openoct/OCT-Spectrometer-800nm/Mechanics/readme.md

# Open OCT Spectrometer Mechanical Design

This directory contains the CAD files, assembly instructions, and parts buy sheet for the mechanical design of the OCT Spectrometer. CAD files are designed in Autodesk Inventor 2025 and converted to .stp format.

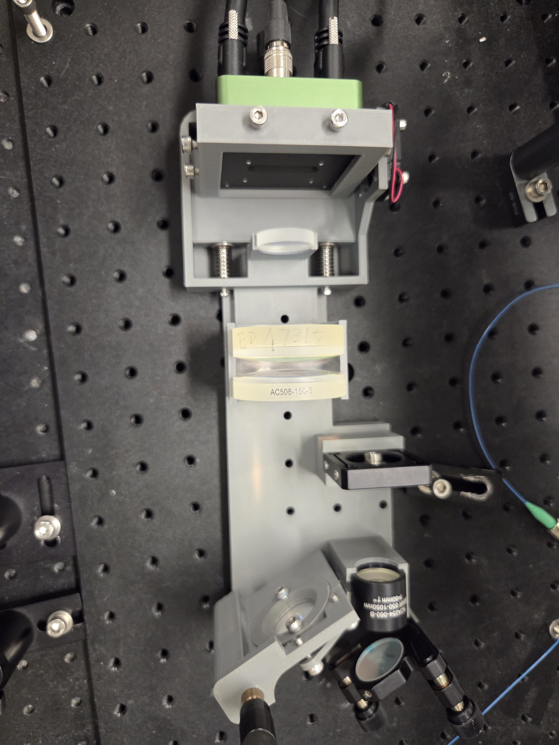
[picture p1: Mechanics/OCT_Spectrometer_v1/OCT Spectrometer Design Photo.jpg]
Photo of the fully assembled spectrometer design.


# Parts Buy List

The [Parts buy list](<OCT_Spectrometer_v1/OCT Spectrometer Parts List - V1.xlsx>) provides all of the components including the optical components listed in the optics repository, along with item count, pricing, and links for purchase.

| Part | Count |
| :--- | :--- |
| ACA254-060-B Thorlabs Lens | 1 |
| AC508-150-B Thorlabs Lens | 1 |
| E-47-318 Fosco Lens | 1 |
| LC1582Thorlabs Lens | 1 |
| 1200 l/mm @ 840 nm CWL Wasatch Photonics Grating | 1 |
| CP08 SM1-Threaded 30 mm Cage Plate Thorlabs | 1 |
| KM100 Mirror Mount Thorlabs | 1 |
| BB1-E03 Mirror Thorlabs | 1 |
| SM1FCA2 Fiber Adapter Plate Thorlabs | 1 |
| ER3 Cage assembly rod Thorlabs | 2 |
| 1/4" - 80 Bronze threaded bushing Thorlabs 0.57" | 2 |
| 1/4" - 80 Fine adjustment screw and knob Thorlabs 1.50" | 2 |
| 7119N117 Ultra-Low-Friction Oil-Embedded Sleeve Bearing McMasterCarr | 4 |
| 28.5 mm x 7mm x 1mm Compression Spring McMasterCarr | 3 |
| EV71YO1 Octoplus CCD Camera (Green) | 1 |
| 5V - 0.17A Fan, CanaKit | 1 |
| M3 - 10mm screw | 4 |
| M4 - 12mm screw | 5 |
| M4 - 25mm screw  | 1 |
| 4-40 - 3/8" screw | 4 |
| M4 - 16mm screw | 1 |
| M4 - Nut | 1 |
| 3D printed components | Full Set |

# Printed Components

This spectrometer contains 3D printed components made of PLA using a Bambu P1S 3D printer. Further printing specification are included in the assembly instructions. The printer contains three 3D components. They have been converted to .stp CAD files for inter-program usage:

The [Grating Casing 1.](<OCT_Spectrometer_v1/Grating Casing 1.stp>)

The [Grating Casing 2.](<OCT_Spectrometer_v1/Grating Casing 2.stp>)

The [Grating Clamp.](<OCT_Spectrometer_v1/Grating Clamp.stp>)

There is also an [Assembly File](<OCT_Spectrometer_v1/OCT Spectrometer Assembly.stp>) for better visualization of the proper CAD arrangement.

# Assembly Instructions

A PDF of [Assembly Instructions](<OCT_Spectrometer_v1/OCT Spectrometer Assembly Instructions.pdf>) is provided to demonstrate the assembly process using the parts listed in the parts buy list.
