openoct/OCT-Spectrometer-800nm/Optics/Zemax_Prescription_Data.md

# Zemax Prescription Data

> Reformatted from the Zemax `System/Prescription Data` text export for easier reading. All numerical values and prescription entries are retained from the source.

## General Lens Data

| Parameter | Value | Note |
| :--- | :--- | :--- |
| Surfaces | 21 |  |
| Stop | 6 |  |
| System Aperture | Object Space NA = 0.13 |  |
| Fast Semi-Diameters | On |  |
| Field Unpolarized | On |  |
| Convert thin film phase to ray equivalent | On |  |
| J/E Conversion Method | X Axis Reference |  |
| Glass Catalogs | SCHOTT CORNING INFRARED MISC |  |
| Ray Aiming | Off |  |
| Apodization | Gaussian, factor = 1.00000E+00 |  |
| Reference OPD | Exit Pupil |  |
| Paraxial Rays Setting | Ignore Coordinate Breaks |  |
| Method to Compute F/# | Tracing Rays |  |
| Method to Compute Huygens Integral | Auto |  |
| Print Coordinate Breaks | On |  |
| Multi-Threading | On |  |
| OPD Modulo 2 Pi | Off |  |
| Temperature (C) | 2.00000E+01 |  |
| Pressure (ATM) | 1.00000E+00 |  |
| Adjust Index Data To Environment | Off |  |
| Effective Focal Length | 64.70061 | in air at system temperature and pressure |
| Effective Focal Length | 64.70061 | in image space |
| Back Focal Length | -80.2245 |  |
| Total Track | 251.4813 |  |
| Image Space F/# | 2.721626 |  |
| Paraxial Working F/# | 6.911701 |  |
| Working F/# | 7.002377 |  |
| Image Space NA | 0.07215254 |  |
| Object Space NA | 0.13 |  |
| Stop Radius | 7.903976 |  |
| Paraxial Image Height | 0 |  |
| Paraxial Magnification | 0 |  |
| Entrance Pupil Diameter | 23.77278 |  |
| Entrance Pupil Position | 41.45787 |  |
| Exit Pupil Diameter | 27.54368 |  |
| Exit Pupil Position | -192.0966 |  |
| Field Type | Angle in degrees |  |
| Maximum Radial Field | 0 |  |
| Primary Wavelength [µm] | 0.84 |  |
| Angular Magnification | 0 |  |
| Lens Units | Millimeters |  |
| Source Units | Watts |  |
| Analysis Units | Watts/cm^2 |  |
| Afocal Mode Units | milliradians |  |
| MTF Units | cycles/millimeter |  |
| Include Calculated Data in Session File | On |  |
| Include Calculated Data in Session File | On |  |

## Fields

- **Number of fields:** 1
- **Field type:** Angle in degrees

| # | X-Value | Y-Value | Weight |
| ---: | ---: | ---: | ---: |
| 1 | 0.000000 | 0.000000 | 1.000000 |

## Vignetting Factors

| # | VDX | VDY | VCX | VCY | VAN |
| ---: | ---: | ---: | ---: | ---: | ---: |
| 1 | 0.000000 | 0.000000 | 0.000000 | 0.000000 | 0.000000 |

## Wavelengths

- **Number of wavelengths:** 1
- **Units:** µm

| # | Value | Weight |
| ---: | ---: | ---: |
| 1 | 0.840000 | 1.000000 |

## Predicted Coordinate ABCD Matrix

|  | Column 1 | Column 2 |
| :--- | ---: | ---: |
| Row 1 | A = 164.3 | B = 0 |
| Row 2 | C = 0 | D = 165.8 |

## Surface Data Summary

| Surf | Type | Radius | Thickness | Glass | Clear Diam | Chip Zone | Mech Diam | Conic | Comment |
| ---: | :--- | ---: | ---: | :--- | ---: | ---: | ---: | ---: | :--- |
| OBJ | STANDARD | Infinity | 49.2 |  | 0 | 0 | 0 | 0 |  |
| 1 | STANDARD | 140.76 | 10.97 | N-SF57 | 22.25 | 0 | 22.25 | 0 |  |
| 2 | STANDARD | 29.8 | 1.15 |  | 20.25 | 0 | 22.25 | 0 |  |
| 3 | STANDARD | 32.59 | 6.1 | N-SSK2 | 22.25 | 0 | 22.25 | 0 |  |
| 4 | STANDARD | -32.59 | 20 |  | 22.25 | 0 | 22.25 | 0 | ACA254-060-B |
| 5 | STANDARD | Infinity | 0 |  | 15.66838 | 0 | 15.66838 | 0 |  |
| STO | COORDBRK | - | 0 |  | - | - | - | - |  |
| 7 | STANDARD | Infinity | 1.5 | F_SILICA | 25 | 0 | 25 | 0 | WASTEC-VPG |
| 8 | STANDARD | Infinity | 0.05 | 1.550000,  0.000000 | 25 | 0 | 25 | 0 |  |
| 9 | DGRATING | Infinity | 0.05 | 1.400000,  0.000000 | 25 | 0 | 25 | 0 |  |
| 10 | STANDARD | Infinity | 1.5 | F_SILICA | 25 | 0 | 25 | 0 |  |
| 11 | STANDARD | Infinity | 0 |  | 18.09534 | 0 | 25 | 0 |  |
| 12 | COORDBRK | - | 102 |  | - | - | - | - |  |
| 13 | STANDARD | 325.1 | 5 | SFL6 | 50.8 | 0 | 50.8 | 0 |  |
| 14 | STANDARD | 95.94 | 8.2 | LAKN22 | 50.8 | 0 | 50.8 | 0 |  |
| 15 | STANDARD | -112 | 2 |  | 50.8 | 0 | 50.8 | 0 | AC508-150-B |
| 16 | STANDARD | 86.842 | 11 | LAKN22 | 50.8 | 0 | 50.8 | 0 | ED47-318 |
| 17 | STANDARD | -86.842 | 5.5 | SFL6 | 50.8 | 0 | 50.8 | 0 |  |
| 18 | STANDARD | -894.7 | 36 |  | 50.8 | 0 | 50.8 | 0 |  |
| 19 | STANDARD | Infinity | 3.5 | SILICA | 25.4 | 0 | 25.4 | 0 |  |
| 20 | STANDARD | 38.6 | 36.96126 |  | 25.4 | 0 | 25.4 | 0 | LC1582 |
| IMA | STANDARD | Infinity |  |  | 3.553457 | 0 | 3.553457 | 0 |  |

## Edge Thickness Data

| Surf | X-Edge | Y-Edge |
| ---: | ---: | ---: |
| OBJ | 49.640322 | 49.640322 |
| 1 | 12.302470 | 12.302470 |
| 2 | 1.334832 | 1.334832 |
| 3 | 2.184753 | 2.184753 |
| 4 | 21.957624 | 21.957624 |
| 5 | 0.000000 | 0.000000 |
| STO | 0.000000 | 0.000000 |
| 7 | 1.500000 | 1.500000 |
| 8 | 0.050000 | 0.050000 |
| 9 | 0.050000 | 0.050000 |
| 10 | 1.500000 | 1.500000 |
| 11 | 0.000000 | 0.000000 |
| 12 | 102.993767 | 102.993767 |
| 13 | 7.429620 | 7.429620 |
| 14 | 1.858417 | 1.858417 |
| 15 | 8.715792 | 8.715792 |
| 16 | 3.404807 | 3.404807 |
| 17 | 8.936978 | 8.936978 |
| 18 | 36.360618 | 36.360618 |
| 19 | 5.649074 | 5.649074 |
| 20 | 34.812186 | 34.812186 |
| IMA | 0.000000 | 0.000000 |

## F/# Data

F/# calculations consider vignetting factors and ignore surface apertures.

- **Wavelength:** 0.840000 µm

| # | Field | Tan | Sag |
| ---: | ---: | ---: | ---: |
| 1 | 0.0000 (deg): | 7.0360 | 6.9692 |

---

Source file: `Prescription_Data(1).txt`
