openoct/OCT-Spectrometer-800nm/Mechanics/OCT_Spectrometer_v1/OCT Spectrometer Parts List - V1.xlsx

Component | Link | Count | Unit Cost | Cost
ACA254-060-B Thorlabs Lens | https://www.thorlabs.com/item/ACA254-060-B | 1 | 616.48$ | 616.48$ |  | Lenses
AC508-150-B Thorlabs Lens | https://www.thorlabs.com/item/AC508-150-B | 1 | 167.78$ | 167.78$ |  | Thorlabs Parts
E-47-318 Fosco Lens | https://www.fiberoptics4sale.com/products/e-47-318-50mm-dia-x-150mm-fl-nir-ii-coated-achromatic-lens | 1 | 433.00$ | 433.00$ |  | Other
LC1582Thorlabs Lens | https://www.thorlabs.com/item/LC1582 | 1 | 25.03$ | 25.03$
1200 l/mm @ 840 nm CWL Wasatch Photonics Grating | https://wasatchphotonics.com/product/1200-lmm-at-840nm/ | 1 | 495.00$ | 495.00$
CP08 SM1-Threaded 30 mm Cage Plate Thorlabs | https://www.thorlabs.com/item/CP08?aID=9b7ad1ce18f38acbfbc35c07a0a58fed&aC=1 | 1 | 24.65$ | 24.65$
KM100 Mirror Mount Thorlabs | https://www.thorlabs.com/item/km100 | 1 | 44.78$ | 44.78$
BB1-E03 Mirror Thorlabs | https://www.thorlabs.com/item/BB1-E03?aID=2bd44a8503c395d2c7328da5cfa22d5d&aC=1 | 1 | 86.91$ | 86.91$
SM1FCA2 Fiber Adapter Plate Thorlabs | https://www.thorlabs.com/item/SM1FCA2?aID=3c165c423fd31a95592191ec19c70f7c&aC=1 | 1 | 39.10$ | 39.10$
ER3 Cage assembly rod Thorlabs | https://www.thorlabs.com/item/ER3?aID=653f3be7440901d5acfa0ead3f6dfa5b&aC=1 | 2 | 7.64$ | 15.28$
1/4" - 80 Bronze threaded bushing Thorlabs 0.57" | https://www.thorlabs.com/item/F25SSN2P | 2 | 6.60$ | 13.20$
1/4" - 80 Fine adjustment screw and knob Thorlabs 1.50" | https://www.thorlabs.com/item/FAS150 | 2 | 8.20$ | 16.40$
7119N117 Ultra-Low-Friction Oil-Embedded Sleeve Bearing McMasterCarr | https://www.mcmaster.com/7119N117/ | 4 | 2.72$ | 10.88$
28.5 mm x 7mm x 1mm Compression Spring McMasterCarr | https://www.mcmaster.com/94125K635/ | 3 | N/A | 9.28$ | Package of 5
EV71YO1 Octoplus CCD Camera (Green) | https://www.teledynevisionsolutions.com/products/octoplus/?model=EV71YO1&vertical=tvs-e2v&segment=tvs | 1 | 6000$ | 6000$
5V - 0.17A Fan, CanaKit | https://www.digikey.com/en/products/detail/adafruit-industries-llc/4468/11587354?gclsrc=aw.ds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 | 1 | 2.95$ | 2.95$
M3 - 10mm screw | Varies | 4 |  | Varies
M4 - 12mm screw | Varies | 5 |  | Varies
M4 - 25mm screw | Varies | 1 |  | Varies
4-40 - 3/8" screw | Varies | 4 |  | Varies
M4 - 16mm screw | Varies | 1 |  | Varies
M4 - Nut | Varies | 1 |  | Varies
3D printed components | N/A | Full set |  | 5$ | Approximate filament cost for all of the pieces
 |  |  | Total | 8005.72$
