openoct/OCT-Spectrometer-800nm/Mechanics/OCT_Spectrometer_v1/OCT Spectrometer Assembly.stp

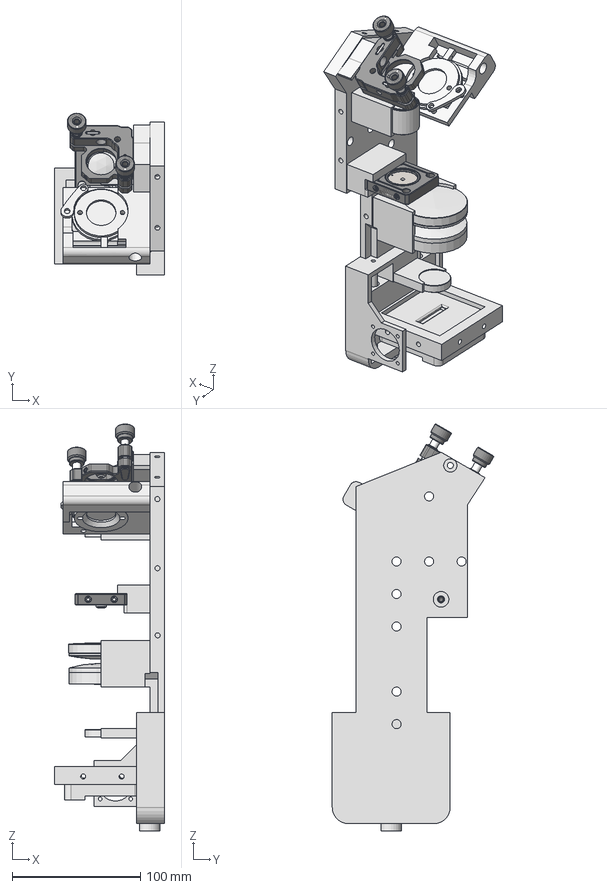
[picture p4: CAD file, 2026-09-07]
Mechanics/OCT_Spectrometer_v1/OCT Spectrometer Assembly.stp
86.1 x 126.2 x 317.8 mm
OCT Jig Block 2
Translation Rod x 2
Single Direction Translation Casing
KM100-Step
ACA254-060-B-Step (1)
CP08-Step
SM1FCA2-Step
Volume Grating x 2
Grating Mount
Grating Mount cap
Grating Rotation Hole
Grating Assembly Cap
PF10-03-P01-Step
AC508-150-B-Step (2)
OCTOPLUS CCD Camera
