openoct/OCT-Spectrometer-800nm/Mechanics/OCT_Spectrometer_v1/Grating Clamp.stp

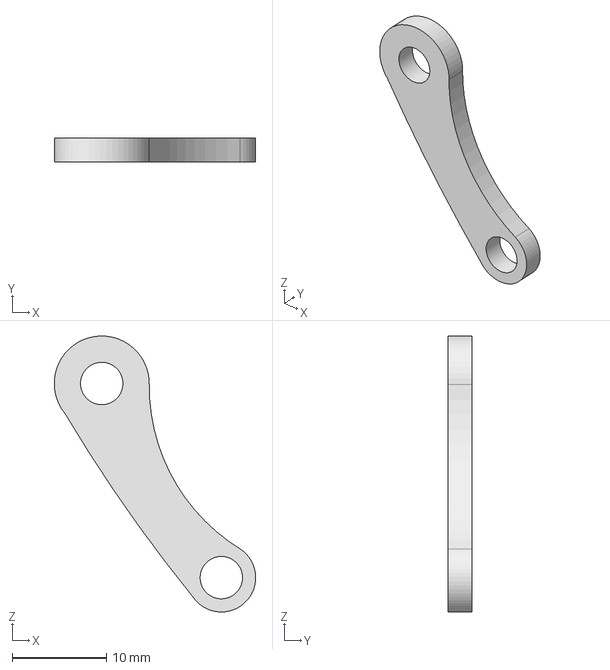
[picture p5: CAD file, 2026-09-07]
Mechanics/OCT_Spectrometer_v1/Grating Clamp.stp
21.4 x 2.54 x 29.3 mm
