openoct/OCT-Spectrometer-800nm/Optics/OpenOCT_spec_3D.STP

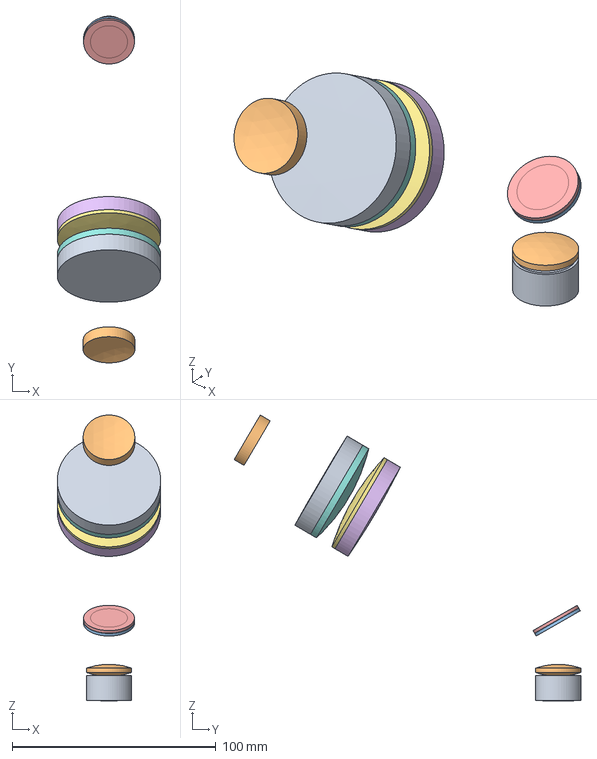
[picture p6: CAD file, 2026-08-15]
Optics/OpenOCT_spec_3D.STP
50.8 x 170.3 x 140.5 mm
