openoct/OCT-Spectrometer-800nm/Mechanics/OCT_Spectrometer_v1/Spectrometer Base.stp

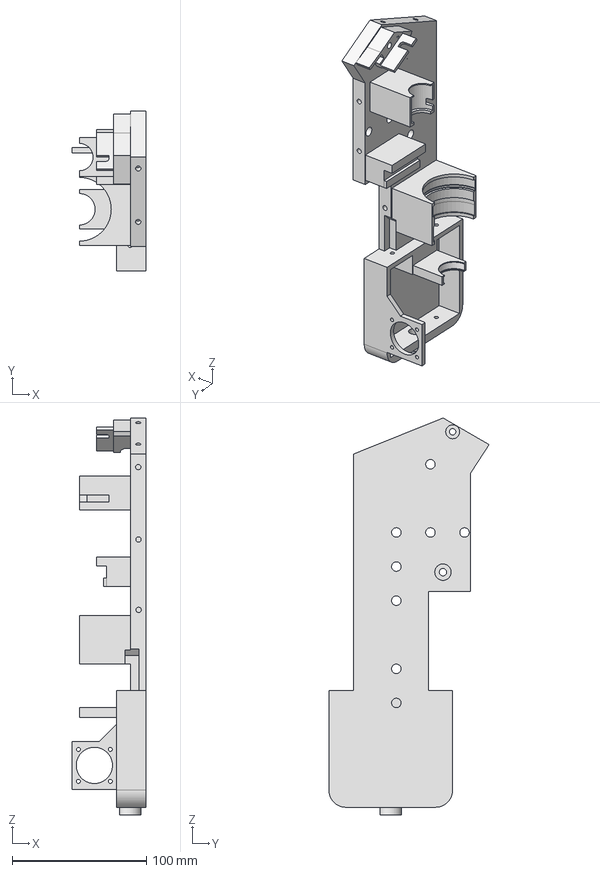
[picture p7: CAD file, 2026-09-07]
Mechanics/OCT_Spectrometer_v1/Spectrometer Base.stp
55.0 x 119.4 x 295.7 mm
