openoct/OCT-Spectrometer-800nm/Mechanics/OCT_Spectrometer_v1/Grating Casing 1.stp

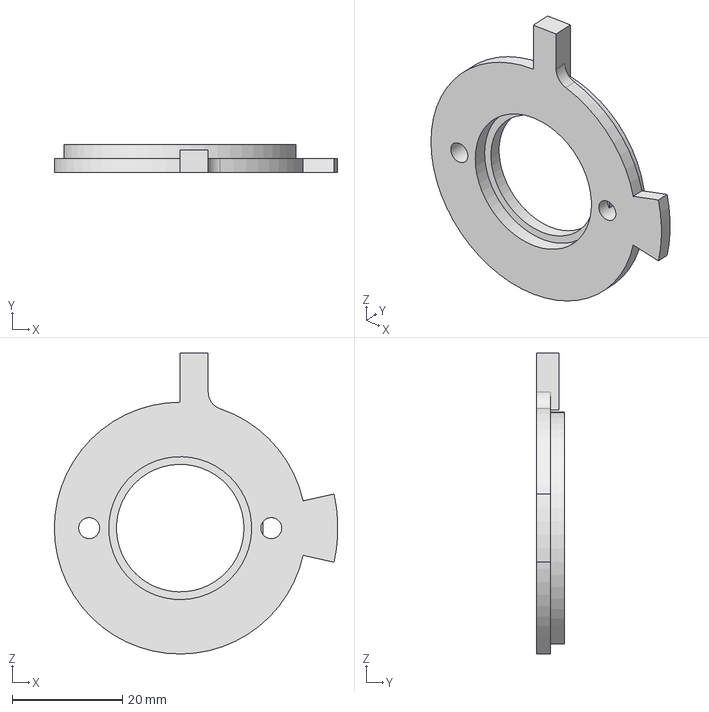
[picture p8: CAD file, 2026-09-07]
Mechanics/OCT_Spectrometer_v1/Grating Casing 1.stp
51.4 x 5.03 x 54.6 mm
