openoct/OCT-Spectrometer-800nm/Mechanics/OCT_Spectrometer_v1/CCD Camera Casing.stp

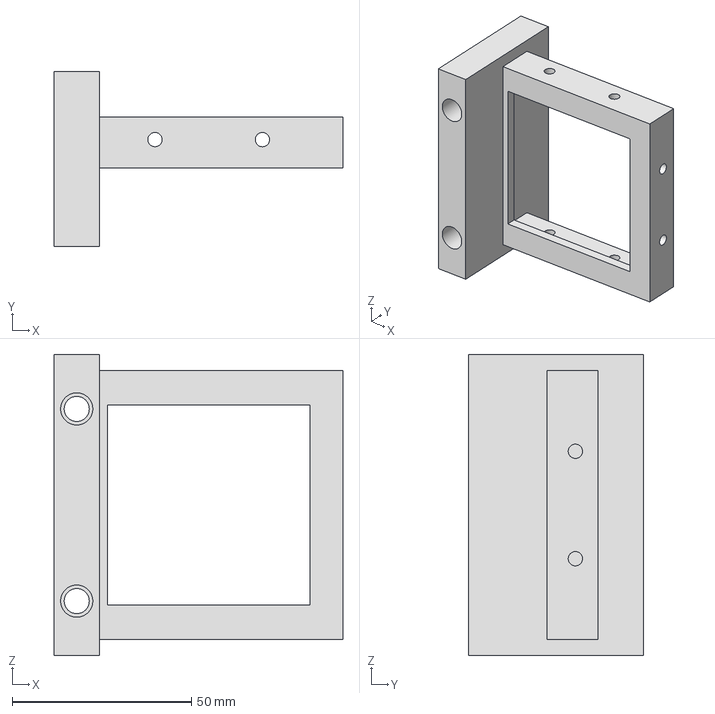
[picture p9: CAD file, 2026-09-07]
Mechanics/OCT_Spectrometer_v1/CCD Camera Casing.stp
80.7 x 49.0 x 84.1 mm
