openoct/OCT-Spectrometer-800nm/Mechanics/OCT_Spectrometer_v1/Grating Casing 2.stp

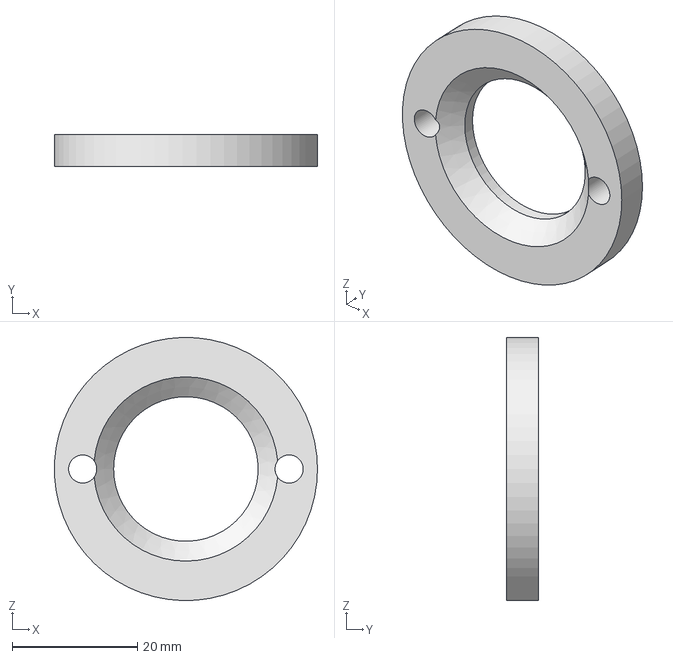
[picture p10: CAD file, 2026-09-07]
Mechanics/OCT_Spectrometer_v1/Grating Casing 2.stp
42.1 x 5.08 x 42.1 mm
